RaysceneNS/SV-650-GearPositionIndicator/img/DSC05228.JPG

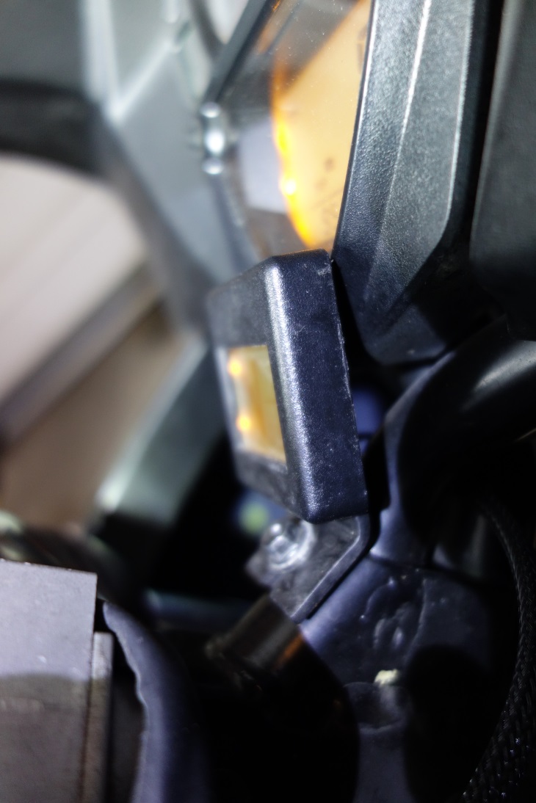
img/DSC05228.JPG
