RaysceneNS/SV-650-GearPositionIndicator/img/DSC05229.JPG

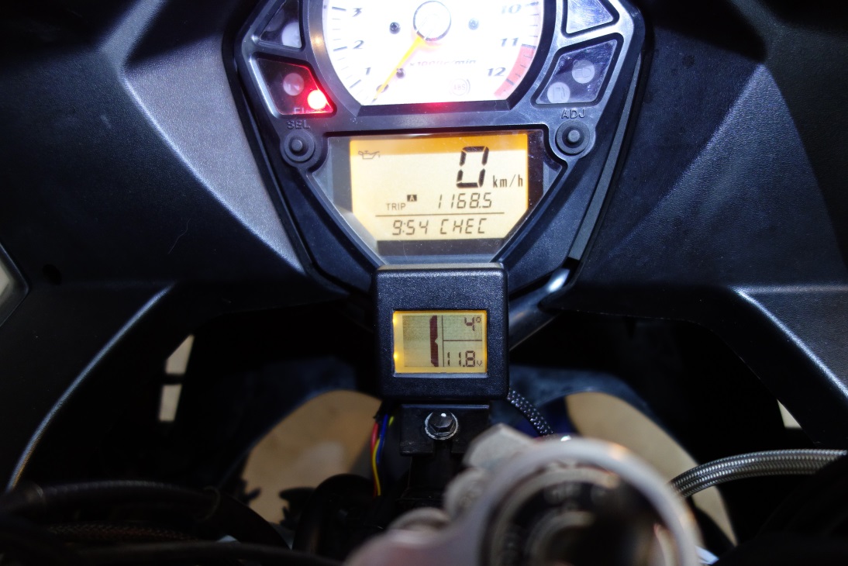
img/DSC05229.JPG
