RaysceneNS/SV-650-GearPositionIndicator/img/DSC05230.JPG

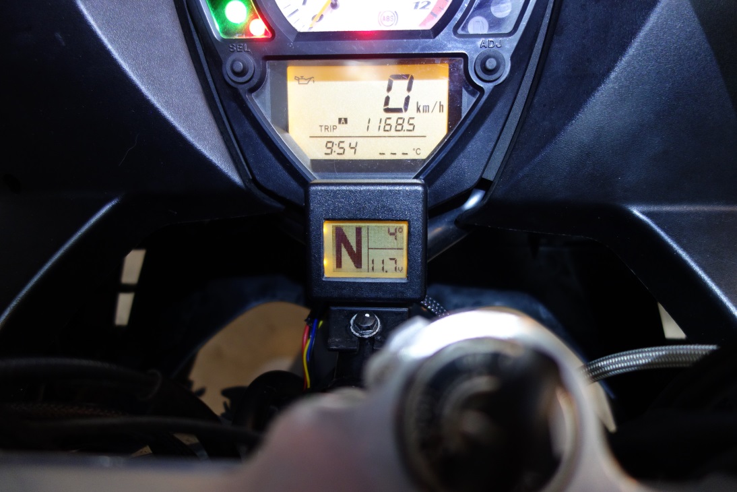
img/DSC05230.JPG
