RaysceneNS/SV-650-GearPositionIndicator/img/DSC05231.JPG

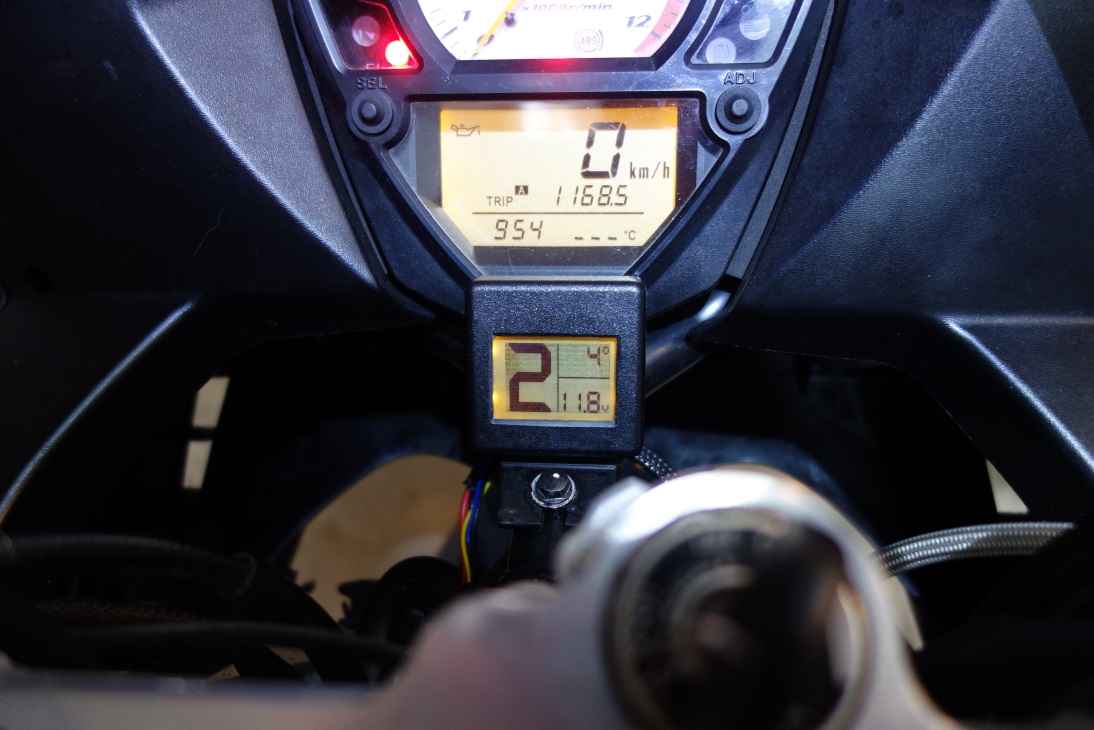
img/DSC05231.JPG
