RaysceneNS/SV-650-GearPositionIndicator/img/ISP 10 way pinout.png

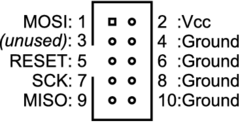
img/ISP 10 way pinout.png
