RaysceneNS/SV-650-GearPositionIndicator/schematic/schematic.pdf

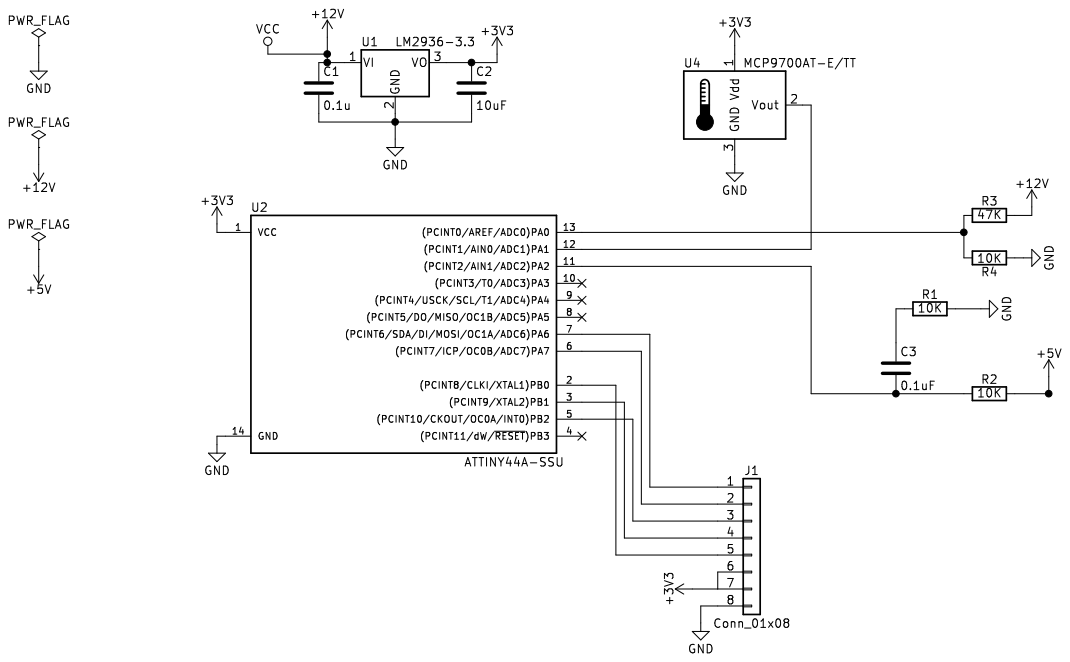
[picture p10: page 1]
