RaysceneNS/SV-650-GearPositionIndicator/(commit log)

2017-09-26 Create Kicad files for board. Limit scope of this model to just gear position.
    [sv650 board.kicad_pcb, sv650 board.sch]
2018-01-04 initial setup
    [sv650 board.kicad_pcb, sv650 board.sch]
2018-03-13 build up adc switching and display output
2018-03-13 Edit gear pin to use 2.5v reference
    [sv650 board.sch]
2018-03-18 updates from device testing.
